OpiyoOscar01/Embedded_Systems_Project_Group_30/(list of files, drawings)

Other design files:
program-sumulation.pdsprj
