OpiyoOscar01/Embedded_Systems_Project_Group_30/(notices)

Notices in the files:
README.md:
License: MIT
